Teodor12/ESP-32-SMART-LIGHTING/README.md

 An offline speech-recognition applicaton for the board ESP32-S3-DevKitC-1 and INMP441 I2S MEMS microphone.
