Teodor12/ESP-32-SMART-LIGHTING/szakdolgozat-obsolete.docx

Szegedi Tudományegyetem Informatikai Intézet

# Beltéri hangvezérelt világítás megvalósítása ESP32 mikrovezérlővel

# Indoor voice-controlled lighting

# using ESP32 microncontroller

Szakdolgozat

Készítette: | Témavezető:
Fodor Teodor | Dr. Mingesz Róbert
mérnökinformatikus szakos hallgató | egyetemi adjunktus

Szeged 2024

Feladatkiírás:

ESP32 mikrovezérlővel számos IOT-projektet elkészíthetünk. A mikrovezérlő sokoldalúságának és könnyen programozhatóságának köszönhetően a lehetőségek tárháza végtelen. Gyakori jelenség, hogy az épületek beltéri megvilágítását különböző elven működő érzékelővel vezérlik. A diplomamunkám célja, hogy a megszokott vezérléseket figyelmen kívül hagyva, egy sokkal kényelmesebb és képzeletet felülmúló, hangvezérelt megoldással álljak elő, amely lehetőleg gyors, könnyen felhasználható és alacsony hiba arányú. A dolgozat írása során természetesen törekszem megtalálni az arany középutat a felhasznált komponensek árában és minőségében, hiszen a legjobb ötlet sem valósítható meg a megfelelő céleszközök nélkül.

A feladat megvalósításának lépései:

1. Pontos specifikáció meghatározása
2. ESP32 fejlesztőkit és mikrofonok kiválasztása
3. Hardverek tesztelése (oszcilloszkóp, egyéb mérések)
4. Program implementálása
5. Program tesztelése
6. Áramkör elkészítése próbapanelen
7. Program javítása és bővítése

Tartalmi összefoglaló:

# A téma megnevezése:

# Beltéri hangvezérelt megvilágítás megvalósítása ESP32 mikrovezérlővel

# A megadott feladat megfogalmazása:

# A feladat követelménye, hogy egy két zónás (két különálló LED-szalagot) világítást tudjunk hanggal vezérelni.

# A megoldási mód:

# A kiválasztott ESP32 fejlesztőkit és mikrofonok közötti kommunikáció szoftveres megvalósítása, majd a az mesterséges intelligencia modellek beiktatása a hang felismeréséhez.

# Alkalmazott eszközök, módszerek:

# A programot a hivatalos, Espressif cég által biztosított ESP-IDF keretrendszert felhasználva készítem el, FreeRTOS-s környezetben. A kapcsolást először breadboard-on rakom össze, majd egy próbapanelen összeforrasztom (a két műveletet megelőzi egy áramkörtervezés).

# Elért eredmények:

# Mind a program, mind az áramkör is elkészült, így a szobámban már megtalálható a működő prototípus.

# Kulcsszavak:

# ESP-IDF, ESP32, I2S, INMP441, FreeRTOS

Tartalomjegyzék:

# 1. Bevezetés:

A hangvezérlés egy olyan technológia, amely lehetővé teszi a különböző eszközök és alkalmazások beszédhanggal való vezérlését. A hangvezérlést biztosító rendszerek használata egyre elterjedtebb a mindennapi életben, például okostelefonok, autók és egyéb elektronikus készülékek esetében. Napjainkban egy korszerű okosotthon szinte teljesen elképzelhetetlen hangvezérlés nélkül. A hangvezérlés egy olyan alternatíva, amely egy érintésmentes és kényelmes szolgáltatást biztosít a hagyományos vezérlési módszerekhez képest.

Felmérések alapján a felhasználók nagy része többnyire a következő 4 platform mellett teszi le a voksát: Apple Siri, Samsung Bixby, Amazon Alexa vagy Google asszisztens. A felsorolt szolgáltatások mindegyikére jellemző, hogy online, azaz felhő-alapú hangfelismerő algoritmusokat futtatnak nagy teljesítményű szervereken. A platformokat támogató termékek (Amazon Echo Dot, Amazon Echo Studio, Apple Homepod, Samsung televízió stb.) valójában egy mikrofonként szolgálnak, amelyek továbbítják a beszédhangot az előbb említett távoli számítógépeknek. Ezen rendszerek általában drágábbak, illetve a használatukhoz egyszerre több terméket is meg kell vásárolnunk. A diplomamunkámmal azt próbálom bemutatni, hogy van lehetőség jutányos áron beszerezni, kiépíteni egy olyan rendszert, amellyel egyszerű eszközök is hangvezéreltté tehetők. Például egy Amazon Alexát támogató villanykörte körülbelül 30 euróba, a hozzá tartozó legegyszerűbb Amazon Echo Dot 50 euróba kerül - az ellátott feladatot természetesen teljesítik az eszközok, azonban az ár egy kissé magas (az Alex-ás termékek árai messze elmaradnak az Apple termékeihez képest) egyetlen funkcionalitás megvalósításához. Az elkészített projekttel be szeretném mutatni, hogy sokkal kevesebb anyagi ráfordítással is megteremthető a fenti kényelmi funkció.

Fontos megjegyezni, hogy ha az ember ESP32 [1] mikrovezérlővel megvalósított hangfelismerés offline hangfelismerés [2], azaz az algoritmus magán az eszközön fut, ezért egy erősebb chip megvásárlása szükséges, amelyben több memória található, illetve az órajele is sokkal magasabb. Az ilyen chipek ára még mindig messzemenőleg elmarad egy felhő-alapú rendszerhez képest. A legegyszerűbb megoldás az, ha az ember vásárol egy olyan fejlesztőkitet, amiben már megtalálható a mikrofon is, így nem kell foglalkozni a hang eljuttatásával a mikrovezérlőbe. Találtam több kitet is, amelybe már integrálva voltak a mikrofonok, azonban a beszerzésük hosszadalmas és drágább folyamat lett volna. Ezért úgy döntöttem, hogy külön-külön beszerzem a fejlesztőkitet és a két mikrofont (lehetőleg olyan típusút, amelyek a hivatalos kitekbe is integrálva vannak) és elkészítem a közöttük lévő kommunikációhoz szükséges illesztőprogramot. A hangfelismerő algoritmust nem én készítettem, már része az ESP-IDF [3] keretrendszernek, és sajnos nem nyílt forráskódú a keretrendszer ezen könyvtára.

# Nem titkolt célja a projektnek, hogy egy pénztárcabarát és könnyen használható, illetve konfigurálható eszközt tervezzek, amely egyszerűbb vezérlési feladatok elvégzésére képes.

# 2. Hardverkörnyezet bemutatása:

# A felhasznált hardverek kiválasztásakor alábbi négy szempont szerint jártam el: legyen költséghatékony, könnyen elérhető, lehetőleg gyors legyen a kiszállítás és ne legyen gyárilag hibás.

## 2.1. A felhasznált mikrovezérlő és fejlesztőkit:


Az Espressif [4] cég ESP termékcsaládja eddig is népszerű volt a hobbi építők és az olcsó IoT eszköz gyártók körében, révén, hogy nagy tudása mellett, olcsó és könnyen programozható. Az elterjedt ESP8266 (illetve ESP8265 és változatai) leváltására érkezett az erősebb ESP32. Az ESP32 az elődjéhez képest sokkal több perifériával, nagyobb memóriával és magasabb órajellel rendelkezik. A programozható pinek száma megnőtt, illetve egyre több hálózati kommunikációs protokollt (Thread, Zigbee, Matter) is képesek támogatni a megszokott WiFi-n és Bluetooth-on kívül az újszériás ESP32 chipek. Az elmúlt évek során rengeteg változat jelent meg, mindegyik széria rendelkezik valamilyen specifikus képességgel, így az adott feladat követelményeinek megfelelően tudjuk kiválasztani a számunkra megfelelő chipet.

Ábra 1 – ESP32 csippel szerelt fejlesztőkit.
Forrás:[5]

Ábra 2 – ESP32-S3 csippel szerelt fejlesztőkit. Forrás:[6]


A diplomamunkámhoz az ESP32-S3 [6] AI SoC-t választottam, amely a már jól bevált két processzormagos, akár 240 MHz-es órajel elérésére is képes Xtensa LX7 vezérlőegységet tartalmazza. A mikrovezérlőt kifejezetten AIoT alkalmazásokhoz gyártotta az Espessif Systems cég 2020-ban. Az ilyen chipet tartalmazó modulok különlegessége, hogy tartalmaznak egy külső PSRAM (Pseudostatic RAM) memóriaegységet, 2,4,8 és 16 MB-os kapacitással, verziótól függően. A PSRAM [7] nagy méretének köszönhetően, lehetővé teszi a magas számításigényű mesterséges intelligencia algoritmusok (esetünkben hangfelismerő algoritmusok) futását, a nagy mennyiségű digitalizált hangadat pufferelését – kizárólag ezért használható csak az S3-as szériához a keretrendszer hangfelismerő könyvtára. A jelenlegi projekthez én ESP32-S3-DevKitC-1U-N8R8 chip-el ellátott ESP32-S3-DevKitC-1 v1.1 fejlesztőkitet választottam 8MB flash-memóriával és 8 MB PSRAM-mal. [6]


Ábra 3 – Espressif cég által gyártott PSRAM csip. Forrás: [7]

## 2.2. A felhasznált mikrofonok:

Annak érdekében, hogy a beszédhang digitalizálásával ne kelljen foglalkoznom, mindenképpen egy MEMS-technológiát használó mikrofont választottam, illetve egy olyan kommunikációs protokollt, amellyel könnyen le tudom implementálni a mikrofon és a fejlesztőkit közötti adatátvitelt. Ha körül nézünk a boltok polcain, akkor legtöbb ilyen típusú mikrofon az I²S kommunikációs szabványt támogatja. Az ESP-IDF pedig rendelkezik olyan könyvtárral, amely a fenti kommunikáció lebonyolításáért felelős.

### 2.2.1. A MEMS-technológia:

A MEMS mikrofonokat [8] vagy szilíciummikrofonokat már régóta előszeretettel használják okostelefonokban, okostévékben, távirányítókban. Ez nagy részben olyan hangvezérelt személyititkár-alkalmazásoknak köszönhető, amilyen a korábban is más sokszor emlegetett Amazon Alexa, a Google Assistant és az Apple termékek Siri-je. Ezek az alkalmazások olyan hangparancsokra várnak, amelyek ébresztik magát a rendszert, majd a parancs alapján hajtanak végre különböző utasításokat. A tervezők szűrőfunckiókat is integrálnak a mikrofonokba, hogy azok pontosan, jelentős környezeti zajban is messziről érzékeljék a beszédhangot.

A MEMS mikrofonok jellemzően két, egyazon tokban elhelyezett alkatrészből állnak: egy MEMS membránból, amely átalakítja a hanghullámokat elektromos jellé, valamint egy erősítőből, amely impedanciaátalakítóként működve használható analóg kimenő jelet ad a hangfrekvenciás jelfeldolgozó láncra. A harmadik alkotóelem – ha digitális kimenőjelre van szükség – egy analóg-digitális átalakító, amely szintén elhelyezhető ugyanabban a tokban, számunkra ez a fontos a projekt esetében. [8]

# A MEMS-mikrofonok fontosabb paraméterei a következők:

Jel-zaj viszony (signal-noise ratio, azaz SNR): a hasznos és a zavaró jel aránya dB-ben kifejezve. Minél alacsonyabb, annál több zaj jelenik meg a digitalizált adatokban. Törekedni kell a nagyobb jel-zaj viszonyú mikrofonok kiválasztására, így az eszköz kevésbé „zajosabb” és kevésbé érzékenyebb a zajra.

# Frekvenciaátvitel: megadja azt a hangfrekvencia tartományt, ahol a mikrofon képes érzékelni a beszédhangot.

# Dinamikatartomány: azon leghangosabb és leghalkabb hangnak megfelelő hangnyomásszint közti különbség, amelyek között a mikrofon jelleggörbéje lineáris.

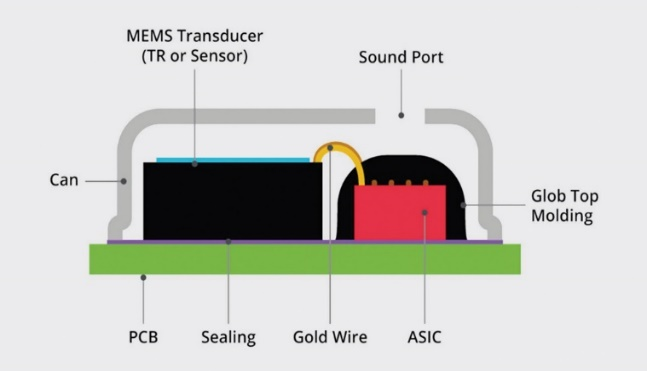
[picture p31: figure]

# Érzékenység: megadja, hogy a mikrofon egy 1 kHz-es 94 dB hangnyomású hanghullámra adott analóg/digitális kimeneti értékének nagyságát

Ábra 4 – MEMS mikrofon csip. Forrás: [9].

Ábra 5 – MEMS mikrofon belső felépítése. Forrás: [8].


Digitális MEMS mikrofon használata esetén a mikrofon kimenőjele közvetlenül rávezethető digitális áramkörökre, általában egy mikrovezérlőre. Az erősen zajos környezetekre tervezett hangvezérléses felhasználói felületek jellemzően inkább a digitális mikrofonokat részesítik előnyben, mert a digitális kimenő jeleknek nagyobb a zajtűrésük, illetve a kezelésük is könnyebb, mint az analóg társaiknak.

### 2.2.2. INMP441:


Az INMP441 [10] egy olcsó és könnyen beszerezhető, alacsony fogyasztású MEMS mikrofon modul. Fontos tulajdonsága, hogy I²S kimeneti interfésszel rendelkezik és omnidirekcionális, ami azt jelenti, hogy minden irányból egyformán érzékeli a hangot. A kimenete 24-bites és könnyen alkalmazható sztereó módban, azaz egyszerre 2 azonos típusú mikrofont is könnyen használhatunk - az architektúrájából kifolyólag szinkronizálva van a mikrofonok közötti adatátvitel.

Ábra 8 – INMP441 mikrofonnal szerelt mikrofon. Forrás: [11].

Ábra 7 – 2 INMP411 mikrofon sztereó módban használva.
Forrás: [10].

Ábra 6 – az INMP441 mikrofoncsip belső felépítése. Forrás: [10].

# A fenti ábrán jól látható a „L/R” pin a mikrofon blokkdiagramján – ennek segítségével konfigurálható, hogy az eszköz a „jobb” vagy a „bal” oldali csatornán küldje a

# kimeneti adatot. Az 7-es ábra szemlélteti a sztereó-kimenet kapcsolását.

Jól látható, hogy az egyik mikrofon csip L/R pinjét tápfeszültségre, míg a másik eszköz L/R pinje GND-re van csatlakoztatva. Az ábrán feltüntetett szűrőkondenzátorok és ellenállások már alapból megtalálhatóak a mikrofonos lapocskán, ezért használatuk elhanyagolható. Az ábra utolsó fontos eleme, a „SYSTEM MASTER” blokk esetünkben nem más, mint maga az ESP32 S3-as fejlesztőkit.

### 2.2.3. I²S szabvány:

Az I²S [12] (Inter-IC Sound) egy elektronikus soros busz interfész szabvány, amelyet digitális audióeszközök összekapcsolására használnak. Ezt a szabványt először a Philips Semiconductor vezette be 1986-ban. Digitális audió adatok átvitelére használják az elektronikus eszközök integrált áramkörei között. A kimenet PCM-formátumú.

# Összesen 3 jelalak jellemzi:

# Bit órajel – az általunk használt mikrofon esetében ez az SCK-pinen (serial clock) jelenik meg. Feladata a bitek átvitelének az ütemezése

Szó óravonal – formálisan ez a mikrofon WS-pinjének (word select) a jele. Feladata, hogy sztereó kimenet esetén kiválasztja, hogy a jobb vagy bal oldali csatornáról szeretnénk fogadni az adatot. Logikai alacsony szint esetén a bal-, míg logikai magas jelszint esetén a jobb csatornáról történik az adat olvasása. Leegyszerűsítve ez a mintavételi frekvencia egy szóra vonatkozóan, ami esetünkben 24-bit (32 bit).

# Soros adatvonal – ezen az adatvonalon jelennek meg a mikrofon által digitalizált adatok bájtjai. Az INMP441 mikrofon esetén ez az SD-pin (serial data).


Ábra 7 – Az I2S idődiagramja. Forrás: [12].


Ábra 8 – Az INMP441 mikrofon I2S idődiagramja sztereó-kimenet esetén.
Forrás: [10].

Adatlap alapján a mikrofon kimenetén 24-bites adatok jelennek meg, amelyek a legnagyobb helyiértékű bittel kezdődnek. A dolog érdekessége, hogy mégis 32 jelenik meg egy fél-WS-ciklus (1 darab csatorna olvasása) alatt. Ez azzal magyarázható, hogy a mikrofon ilyenkor egy magas impedanciás állapotba kerül – ezek a bitek számunkra közömbösek és a szoftveres lekezelésénél is figyelmen kívül hagyjuk őket. Kicsit nehezebben észrevehető, de még mielőtt kiolvasnánk a digitalizált adat legnagyobb helyiértékű bitjét a WS-ciklus elején, szükségünk van egy bit-órajel impulzusra (eltolás), ez a formátum a „Philips formátum”. Az ESP-IDF I²S könyvtárában [13] ez szerencsére gond nélkül konfigurálható. Fontos még kiemelni, hogy egy teljes WS-ciklus alatt 64 SCK impulzusnak kell megjelennie annak ellenére, hogy csak 24 bit a számunkra értékes információ. [8]


Ábra 9 – az INMP441 vizsgálata oszcilloszkóppal. Kékkel a WS-, pirossal az SCK- és zölddel az SD- jel látható.

## 2.3. A felhasznált LED szalag:

Végül, de nem utolsó sorban a megvilágításért felelős LED-szalagról teszek említést. A két szalagot a szobámban található két szekrény hátoldalán helyeztem. Miután lemértem a szekrények hosszait, méretre vágtam a szalagokat, végül felragasztottam őket. Ehhez a szalagon található ragasztón kívül még univerzális ragasztót is felhasználtam a biztos tapadás érdekében. Összesen 3 méter szalagra volt szükségem, amelyekről a gyári csatlakozót le kellett cserélnem csupasz vezetékekre.

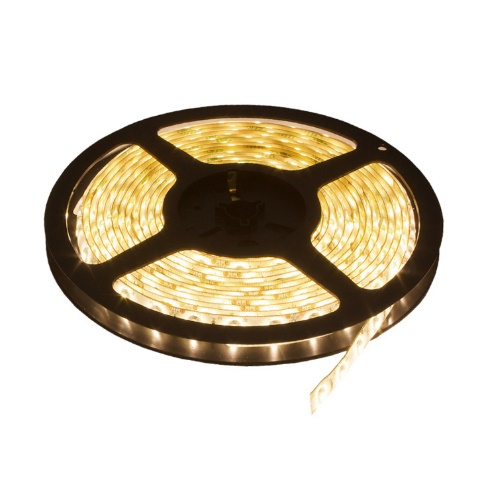
[picture p32: figure]

A műszaki paramétereket áttekintve egy 12 V-on működő, méterenként 120 LED diódával szerelt szalagról van szó, 3000K színmélységgel (ún. “meleg fehér” a szalag által emittált fénysugár). Számomra fontos paraméter volt a dimmelhetőség, mivel egyszere 5-6 különböző fényerősséget szerettem volna felkínálni, amelyeket a hangparancsokkal lehet változtatni. A különböző fényerősségek eléréséhez természetesen PWM-jelet alkalmaztam.

Ábra 10 – COB LED-szalag. Forrás: [14]


Kihagyhatatlan volt a felhasznált teljesítmény és áramerősség meghatározása is, hiszen a rendszerhez egy megfelelő méretű tápegységet is be kellett szereznem. Mérések és kísérletezés alapján a két LED szalag egyenként 750 mA-t fogyasztott (maximális fényerősség esetén), illetve a mikrovezérlő elenyésző fogyasztását is beleszámoltam, aminek eredménye egy 3A áramerősségű 12 voltos tápegység [15] lett. (230V hálózati feszültségről alakít). A fejlesztőkit tápfeszültséggel való ellátásáért egy LM2596 [16] DC-DC kapcsolóüzemű konvertert használtam, melynek kimeneti feszültségét 3.3V-ra állítottam.

Ábra 11 – a projekt megvalósításához felhasznált tápegységek. Bal oldalon a 12V-os AC/DC átalakító, jobb oldalon pedig az LM2595-os DC/DC átalakító. Forrás: [15, 16].

## 2.4. Egyéb felhasznált eszközök:

# Műanyag doboz – 95 x 60 mm méretű, az áramkör tárolására

# Próbapanel – a dobozhoz mérten méretre vágtam, erre forrasztottam az áramkört

# IRL540N [17] logikai MOSFET – a két LED szalag meghajtására használtam. Önmagában az ESP32 fejlesztőkit GPIO lábai nem képesek 12 voltos eszközöket meghajtani. A tranzisztor threshold feszültsége 1.8-1.9 V, ami könnyen kapcsolható a kit 3.3 V-os pinjeivel. [14]

# Ellenállások – 100 Ω és 10 kΩ értékkel

# 2.54mm lábtávolságú aljzat: a fejlesztőkit és a mikrofonok könnyebb rögzítéséhez és esetleges cseréjéhez

# DC-csatlakozó – egy tápegység, egy csatlakozó. Az egyszerűség kedvéért barrel-jack-t használtam

# Kétutas csavaros sorkapocs – ezzel kötöttem a LED szalagokat az áramkör kimeneteire

## 2.5. A felépített áramkör:

Ábra 12 – a projekthez használt áramkör kapcsolási rajza


A fenti ábra alaposan bemutatja az általam tervezett áramkört. A program, amelyet használtam a kapcsolási rajz elkészítéséhez a nyílt-forráskódú és ingyenesen letölthető KiCad. A könnyebb átláthatóság érdekében a vezetékek helyett címkéket használtam (pl. OUTPUT1, I2S_SDIN stb.). Szeretném kiemelni, hogy az áramkör 3 dimenziós modelljét, amely a nyomtatott áramköri lapot tartalmazza, nem készítettem el, ezért is érdemesebb a rajzra egy funkcionális diagramként tekinteni, amely a forrasztás során segített létrehozni a megfelelő kapcsolásokat (erre jó példa a LM2596 DC-DC átalakítónak csak a integrált áramköri komponense van feltüntetve az ábrán). A sokszor felhasznált részeket (+12v, GND) egységesítettem.

Jobb felső sarokban található az áramkör tápellátásért felelős részegység. A J1-es jelzésű BarrelJack-en keresztül tápláljuk meg 12 volttal a rendszert a 13-as ábrán található AC-DC tápegységgel. Ezt a 12 volt feszültséget használjuk fel a LED szalagok meghajtására illetve közvetett módon a fejlesztőkit áramellátására is: az LM2596 DC-DC átalakító a 12 voltot 3.3 voltra alakítja át, amely a fejlesztőkit 3V3 kivezetésére csatlakozik.

Az ábra bal alsó sarkában látható a ESP32 S3 fejlesztőkit. Az „I²S” előtaggal rendelkező kivezetéseket szabadon választottam, ügyelve arra, hogy az eszköz működéséhez szükséges pineket (BOOT, GND, RST stb.) ne használjam. Hasonló módon jártam el az OUTPUT1 és OUTPUT2 pinek esetén is, általános célú lábakat választottam, amelyek a későbbiekben a váltakozó kitöltési tényezőjű PWM-jeleket juttatják el a logikai MOSFET tranzisztorokra.

Az ábra bal felső sarkában található a két darab INMP441-es omnidirekcionális mikrofonmodul. Ezeket is LM2596-os feszültségkonverter látja el tápfeszültséggel, adatlapi értékek alapján maximálisan 3.6V-al táplálhatóak. A korábban említett sztereó konfiguráció érdekében az egyik L/R kivezetését a rendszer földpontjára, míg a másikat 3.3 V feszültségre kötöttem. A további három vezeték az I²S által szükséges jelek továbbítására szolgál, amelyek az I2S_WS (word select), I2S_SD (serial data) és I2S_SCK (serial clock).

Az áramkör utolsó részegysége a LED szalagok meghajtásáért felelős aláramkör a kapcsolási rajz jobb alsó sarkában. Az RG1 és RG2 ellenállások 100 Ω-sak, míg az RGND1 és RGND2 10kΩ-sak. Az RGND1 és RGND2 ellenállások lehúzó ellenállásként funkcionálnak, így biztosítva azt, hogy a mikrovezérlő bootolásakor a tranzisztorok kimenetei nem magas impedanciás-, hanem biztosan kikapcsolt állapotban vannak. Az RG1 és RG2 ellenállás megléte nem kötelező, hiszen a logikai térvezérlésű tranzisztorokat elméleti szinten kizárólag feszültséggel vezéreljük, azonban tudjuk, hogy a gyakorlatban némi áram is megjelenik a mosfet gate-jén – a két ellenállás a túláramok ellen biztosít védelmet. [18] Noha a egy feszültségosztó áramkört kapunk, az RG1 és RG2 ellenállásértékei elenyészőek a 10kΩ-hoz képest, ezért a jelenlétük nem fogja zavarni a működést:

# R1 = 100 Ω

# R2 = 10000 Ω

# V = V_(out) * ((R2)/((R1 + R2)))= 3.3V*( (10000Ω)/(10100 Ω))=3.267 V

A kapott „V” feszültség érték messze meghaladja az IRL540 fet threshold feszültéségét (kb. 1.8-1.9 V). A tranzisztor drain kivezetése a csavaros sorkapocs egyik lábára csatlakozik, természetesen arra, amelyre a LED szalag negatív polaritású vezetékét kötöttem, míg másikra, amelyen a 12V-os tápfeszültség van, a szalag pozitív vezetéke került bekötésre. A tranzisztorokat meghajtó pwm-jel biztosítja azt, hogy azokat kapcsolóüzemben használjuk így további munkapont beállításra nincs szükség. A tranzisztor N-csatornás, így a bemeneten megjelenő négyszögjel a szalag földpontját nagyfrekvencián szaggatja” (dimmeli), a váltakozó kitöltési tényező pedig a jel effektív értékét, azaz a fényerőt szabályozza.

# 3. Szoftverkörnyezet bemutatása:

## 3.1. Espressif IoT Development Framework:

Az ESP-IDF a kínai Espressif cég által fejlesztett keretrendszer, amelyet az ESP8266- és ESP32 sorozatú mikrovezérlők programozására használunk. Az szoftvercsomag rengeteg API-t kínál, amellyel kényelmesen programozható a mikrovezérlő minden egyes perifériája és felkínált szolgáltatása, C és C++ programozási nyelveken egyaránt. Fontos kiemelni, hogy maga a keretrendszer és annak szoftverkomponensei a FreeRTOS [19] valós-idejű operációs rendszer alapjaira vannak lefektetve, amely kivétel nélkül mindegy egyes Espressif-es csipet támogat-

A keretrendszer nagy előnye, hogy teljesen nyílt-forráskodú, szabadon megtekinthetőek a forrásfájlok a hivatalos GitHub repository-ban, emellett jól dokumentált, minden apró részletre kitér és, ami a legfontosabb, hogy az egyes könyvtárakhoz példaprogramokat is bemutat, amelyek a dokumentáció olvasásával kombinálva megkönnyítik és felgyorsítják a fejlesztést. [3]


## 3.2. FreeRTOS:

Ábra 13 – az idf.py menuconfig parancs futtatása után megjelenik a konfigurátor interfész, jelen esetben a FreeRTOS-ra vonatkozó opciókat láthatjuk


A valós idejű operációs rendszer, mint olyan, egy erőforráskímélő operációs rendszer, amely lehetővé teszi a többfeladatos programvégrehajtást. Maga a „valós idő” az adott folyamat elvégzéséhez szükséges idő determinisztikusságára és (vagy) mennyiségének megjósolhatóságára utal. A beágyazott rendszerek többnyire valós idejű (Real-Time) követelményeket támasztanak, ami azt jelenti, hogy egy-egy esemény bekövetkezésére adott időkorláton belül reagálni kell. [19]

Ábra 14 – FreeRTOS logó. Forrás: [19].

### 3.2.1. Feladatok:

A FreeRTOS az adott feladatok (taszk) között osztja meg az hardver erőforrásait. A taszkok egymástól független végtelen ciklusban futó függvények, amelyek az adott mikrovezérlő heap-memóriájából foglalnak le a stack-ük nagyságával megegyező memóriát. Bár a taszkok logikailag el vannak szigetelve egymástól, az MPU (memória védelmi egység) a különböző memóriaterületek védelmét szolgálja, megakadályozva, hogy egy taszk egy másik taszk memóriaterületére írjon vagy olvasson. [19]

# A feladatok különböző állapotúak lehetnek:

# Blokkolt (blocked/suspended) – a feladat eseményre vár (pl. késleltetés leteltére, adatok/erőforrások elérhetővé válására)

# Felfüggesztett (suspended) – a feladat nem kap erőforrást és nem kerül ütemezésre

# Készenléti (ready) – a feladat a CPU-n történő futásra kész, de nem fut, mert a CPU erőforrásait egy másik feladat használja

# Futó (running) – a CPU erőforrást biztosít a feladat futásához

### 3.2.2. Rendszerórajel:

A FreeRTOS-nak szüksége van egy időalapra az idő méréséhez, illetve az ütemező működéséhez. Ez általában egy számláló változó segítségével valósul meg, amelyet a hardver egy periodikusan generált megszakításkezelő függvényben növel. A rendszerórajelnek köszönhetően egy alkalmazás több időalapú szolgáltatást (feladat-végrehajtási intervallumot, várakozási időtúllépést, időszeletelést) képes fenntartani egyetlen hardveres időzítő használatával. A gyorsabb rendszerórajel azonban csak az RTOS időalap felbontását növeli, a szoftver futási ideje nem javul tőle. [19]

### 3.2.3. Ütemező:

A FreeRTOS-ban futó feladatok ütemezését az ütemező végzi. Típusa szerint ez egy preemptív ütemező, ami azt jelenti, hogy a taszkokhoz a létrehozásukkor egy prioritás értéket rendelünk, így az ütemező ezen érték alapján osztja meg az erőforrásokat és a processzoridő a taszkok között. A különböző értékek megléte miatt a magasabb prioritással rendelkező feladatok megszakíthatják az alacsonyabb prioritással rendelkező társaikat. [19]

### 3.2.4. Feladatok közötti kommunikáció (ITC):

Ha több feladatot futtatunk párhuzamosan, gyakori jelenség a köztük lévő információcsere, illetve egy globális változó írása/olvasása. Az ilyen „közös” entitások megléte gyakran idézhet elő versenyhelyzetet. Ekkor kettő (vagy több task) egyszerre próbálja meg elérni a globálist változót, ami a benne lévő adat sérülését okozhatja. Az információk megosztása mellett a FreeRTOS-objektumok képesek szinkronizálni a feladatok végrehajtását is. A feladatok blokkolhatóak, várhatnak egymásra – ez esetben a jelenhet a meg holtpont (dead-lock), amikor két vagy több taszk egymást blokkolja, mivel mindegyik vár valamilyen erőforrásra, amit egy másik birtokol. Ennek eredményeként egyik folyamat sem tud előre haladni, és a rendszer megreked. [19]

# A FreeRTOS a következő objektumokkal rendelkezik:

# Üzenetsor (queue vagy message queue) - Adatok küldésére szolgál a feladatok vagy a megszakítás és a feladat között, FIFO technikát alkalmaz

# Mutex –egyetlen erőforrás használatának védelmére használatos

# Szemafor - Az erőforrások használatának védelmére vagy a feladat-végrehajtás szinkronizálására szolgál. Lehet bináris- és számláló szemafor.

# Eseménycsoport (Event group): valójában egy 8- vagy 16 bites változó, melynek a meghatározott bit-kombinációi egy adott állapotot vagy esemény bekövetkezését jelzik.

# 4. A program bemutatása:

A projekt megvalósításához összesen 4 komponenst készítettem el. Ezek a hardware_driver, led_indicator, pwm_output és voice_assistant. A projekt architektúráját tekintve a voice_assistant a program fő része, hiszen megteremti a kapcsolatot a fennmaradó 3 komponens között, amelyek egymástól teljesen függetlenül is működőképesek, azonban az elvárt követelmény a képességeik kombinálásával teljesíthető. A program belépési pontja a szokásos „app_main” függvényben található, amely elindítja a voice_assistant komponensben található taszkokat. Minden inicializációs- és konfigurációs lépés a taszkok indulása előtt fut le, hiba esetén jelez a program. A következő fejezetben az elkészített komponenseket mutatom be lépésről-lépésre haladva – minden egyes részegységnél ügyeltem arra, hogy a „publikus header” fájlokban csak az olyan függvényeket helyezzem el, amelyeket később a főprogramban hívok meg és próbáltam a lehető legjobban elrejteni a valós implementációt (fekete doboz). Az alábbi ábrával szemléltetem a teljes projekt logika felépítését, amely útmutatóként szolgál.


Ábra 15 – az idf-projekt strultúrája

## 4.1. A hardware_driver komponens:

A hardware_driver komponens felelős a fejlesztőkit és a két INMP441 típusú mikrofon közötti I²S kommunikáció megvalósításáért. A program talán második legfontosabb része, hiszen egy alapból nem beépített funkcionalitással/képességgel látja el a fejlesztőkitet – jelen esetben a beszédhang digitalizálását, majd a digitalizált értékek mikrovezérlőbe való továbbításáról beszélünk.

# Header fájl(ok):

esp_err_t bsp_board_init(uint32_t sample_rate, int

channel_format, int bits_per_chan);

esp_err_t bsp_read_i2s_data(int16_t *buffer, int buffer_size);

esp_err_t bsp_board_deinit(void);

int bsp_board_channel_fmt(void);

#define GPIO_I2S_WS (GPIO_NUM_11)

#define GPIO_I2S_MCLK (GPIO_NUM_NC)

#define GPIO_I2S_SCLK (GPIO_NUM_12)

#define GPIO_I2S_DIN (GPIO_NUM_10)

#define GPIO_I2S_DOUT (GPIO_NUM_NC)

#define I2S_CONFIG_DEFAULT(sample_rate, channel_fmt, bits_per_chan)

{

.clk_cfg = I2S_STD_CLK_DEFAULT_CONFIG(sample_rate),

.slot_cfg = I2S_STD_PHILIPS_SLOT_DEFAULT_CONFIG(bits_per_chan, channel_fmt),

.gpio_cfg = {

.mclk = GPIO_I2S_MCLK,

.bclk = GPIO_I2S_SCLK,

.ws = GPIO_I2S_WS,

.dout = GPIO_I2S_DOUT,

.din = GPIO_I2S_DIN,

.invert_flags = {

.mclk_inv = false,

.bclk_inv = false }}

};

A bsp.h (felül) tartalmazza a komponens által publikusan felkínált függvények deklarációját, míg az esp32_s3_devkitc_config.h (alul) a közvetlen módon definiált pineket, amelyeket később az I²S a komponens implementációjánál használtam fel. A “GPIO_NUM_NC” jelzi, hogy az adott pineket nem használjuk majd – az DOUT pinre azért nincs szükségünk, mert nem küldünk adatot a fejlesztőkitből, illetve felesleges az MCLK is, mivel nem biztosítok referencia órajelet a mikrofonoknak.

# Source fájl(ok):

#include "freertos/FreeRTOS.h"

#include "freertos/semphr.h"

#include "esp_log.h"

#include "esp32_s3_devkitc_config.h"

#include "driver/i2s_std.h"

#include "driver/i2s_common.h"

#include "bsp.h"

#define TAG "bsp"

static SemaphoreHandle_t i2s_mutex = NULL;

static i2s_chan_handle_t rx_handle = NULL;

static esp_err_t init_i2s_mutex(void)

{

i2s_mutex = xSemaphoreCreateMutex();

return (i2s_mutex != NULL) ? ESP_OK : ESP_FAIL;

}

A mutex-k használatára azért volt szükség, mert a program egyszerre több taszkot fog párhuzamosan futtatni: könnyen kialakulhatnak olyan helyzetek, amikor egy adott entitást már az előtt szeretnénk használni, hogy befejeződött volna az alap állapotba való helyezése. Mutex használatával könnyen és elegánsan tudjuk elérni, hogy egyszerre több folyamat ne tudja elérni az adott memóriaterületet, így elkerülve az esetleges felülírásokat és befejezetlen inicializációs lépéseket.

static esp_err_t i2s_init(i2s_port_t i2s_port_num, uint32_t sample_rate, int channel_format, int bits_per_chan)

{

esp_err_t ret = ESP_OK;

ESP_ERROR_CHECK(init_i2s_mutex());

xSemaphoreTake(i2s_mutex, pdMS_TO_TICKS(0));

i2s_chan_config_t channel_cfg = I2S_CHANNEL_DEFAULT_CONFIG(i2s_port_num,

I2S_ROLE_MASTER);

ret |= i2s_new_channel(&channel_cfg, NULL, &rx_handle);

i2s_std_config_t std_cfg = I2S_CONFIG_DEFAULT(sample_rate, channel_format,

bits_per_chan);

ret |= i2s_channel_init_std_mode(rx_handle, &std_cfg);

ret |= i2s_channel_enable(rx_handle);

xSemaphoreGive(i2s_mutex);

return ret;

}

Az implementáció elrejtéséhez a C-programozási nyelven static függvényeket használunk, ez a kulcsszó jelzi a fordítóprogramnak, hogy az adott függvényt csak az őt tartalmazó fordítási egységből tudjuk elérni és hívni (ebben az esetben az őt tartalmazó fájlból). A szálbiztos inicializáció abban merül ki, hogy a mutex-t zároljuk, majd az inicializációt követően. „visszaadjuk”.

esp_err_t bsp_board_init(uint32_t sample_rate, int channel_format, int bits_per_chan)

{

esp_err_t ret = ESP_OK;

ret |= i2s_init(I2S_NUM_1, sample_rate, channel_format, bits_per_chan);

if(ret == ESP_OK){

ESP_LOGI(TAG, "I2S peripherial intialized successfully.");

}

else {

ESP_LOGI(TAG, "Error while initializing I2S peripherial.);

}

return ret;

}

# A bsp_board_init publikus függvény valójában csak meghívja a felhasználó elől elrejtett, statikus i2s_init függvényt – callback pattern. Amennyiben i2s periféria inicializálása sikertelen, hibaüzenetet ír ki és visszatér valamelyik esp-idf hibát jelző értékkel, például ESP_FAIL.

static esp_err_t i2s_read_data(int16_t *buffer, int buffer_size)

{

esp_err_t ret = ESP_OK;

size_t bytes_read;

int sample_num = (buffer_size / sizeof(int16_t));

int32_t *temp_buffer = (int32_t *)calloc(sample_num, sizeof(int32_t));

if (temp_buffer == NULL) {

ret = ESP_ERR_NO_MEM;

return ret;

}

i2s_channel_read(rx_handle, temp_buffer, sample_num * sizeof(int32_t), &bytes_read, portMAX_DELAY);

for (int i = 0; i < sample_num; i++) {

buffer[i] = (temp_buffer[i] >> 14);

}

free(temp_buffer);

return ret;

}

esp_err_t bsp_read_i2s_data(int16_t *buffer, int buffer_size)

{

esp_err_t ret = ESP_OK;

ret |= i2s_read_data(buffer, buffer_size);

return ret;

}

Az i2s_read_data függvény under-the-hood módon végzi el a konfigurált I²S-csatornán az adatok beolvasását a paraméterként kapott buffer-be, melynek a mérete buffer_size (bájtokban mérve). A függvény törzsében dinamikusan allokáltam egy 32-bites egészeket (tudjuk, hogy a mikrofonok kimenete 24-bites) tároló tömböt sample_num méretben. A sample_num valójában a később bemutatott hangfelismerő algoritmus által meghatározott hangminta (16-bites érték) mennyisége. Ahhoz, hogy a 32-biten tárolt 24-bites értékek a megfelelő módon kerüljenek a paraméterként megadott pufferbe, el kell shiftelnünk őket a megfelelő mértékben – ügyelve arra is, hogy a felső 8-bit a 32-ből magas impedanciás (jelen esetben határozatlan vagy nulla). Utolsó lépésként szigorúan felszabadítjuk a lefoglalt memóriát.

## 4.2. A led_indicator komponens:

# Az alábbi részegység a felhasználóval való interakciót valósítja meg: lényege, hogy a konfigurált ébresztő hangparancsokra (wakeword) bekapcsolja a fejlesztőkiten található

# RGB-LED izzót. A fehér fényű dióda mindaddig világít, amíg a hangfelismerő algoritmus aktív, ez konfigurációtól függően 5-7 másodperc.


A beépített RGB LED-dióda egy WS2812 [20] modellszámú intelligens, és címezhető dióda. Gyakran alkalmazzák különböző fényeffektusok és egyedi világítást megvalósító projektekhez. Ezekben a LEDek-ben egyetlen integrált áramkör található, amely tartalmazza a piros, zöld és kék diódákat, valamint egy csipet, amely az általuk kibocsátott fény erősségéért, színéért és vezérléséért felelős.

Ábra 16 – az ESP32-S3 fejlesztőkit blokkdiagrammja, pirossal megjelölve a beépített RGB LED-dióda. Forrás: [6].

A diódát még az teszi vonzóvá, hogy egyetlen vezeték elegendő a kommunikáció lebonyolításához: szinte bármilyen mikrovezérlő GPIO-pinjét használva megvalósítható a kommunikáció. A kommunikáció lényege, hogy a mikrovezérlő 24 bites adatcsomagokat küld: az adatcsomagban három 3 8-bites (0-255 skálán terjedő) érték található, amelyek rendre a piros, zöld és kék „fénykomponens” intenzitását reprezentálják. Fontos megjegyezni, hogy a logikai 0 és 1-es érték is kódolva van az ábrán látható módon:


Ábra 17 – a WS2812-es típusú LED-dióda kommunikációs protokolljában felhasznált kódolás. Forrás: [20].

Ahhoz, hogy a diódában levő vezérlő csip a kívánt színkombinációkat tudja előállítani, a logikai nullák és egyesek kódolásnál szigorúan be kell tartani az időzítéseket: a protokoll esetében mind a 4 időtartam (T0H, T0L, T1H és T1l) mikroszekundumos skálán mozog. Külön-külön meghatározott ideig kell, hogy tartson – egy illesztőprogram megírásánál ez nehézkes és meglehetősen időigényes lehet.

# Szerencsére az ESP-IDF nem hivatalos komponensei (ESP Component Registry weboldal [21]) között található a WS2812 (és a hozzá hasonló) diódatípus programozásához szükséges könyvtár – az espressif_ledstrip. Az ilyen és ehhez hasonló könyvtárak az alábbi paranccsal adhatók hozzá a projekthez:

idf.py add-dependency "espressif/led_strip^2.5.4"

# A parancs lényege, hogy létrehozza a projekt main mappájában az idf_component.yaml fájlt az alábbi módon:

dependencies:

espressif/led_strip: "^2.5.3"

idf:

version: ">=4.1.0"

# A fájl tartalmának köszönhetően most már komponensként hozzáadhatjuk az általunk definiálthoz (jelen esetben led_strip) és az #include paranccsal tudjuk beilleszteni az adott forrásfájlba.

# Header fájl:

typedef struct led_indicator *led_indicator_t;

led_indicator_t led_indicator_init();

esp_err_t led_indicator_start(led_indicator_t led_indicator);

esp_err_t led_indicator_turn_on(led_indicator_t led_indicator);

esp_err_t led_indicator_turn_off(led_indicator_t led_indicator);

# A header fájlban definiáltam egy pointert a kód írásának megkönnyítéséhez, amely az általam létrehozott struktúrára mutat (led_indicator_t) – ez a struktúra szintén el van rejtve a header fájlt használó komponensek elől, csak a forrásfájlban található meg.

# Forrásfájl

#include "freertos/FreeRTOS.h"

#include "freertos/semphr.h"

#include "led_indicator.h"

#include "led_strip.h"

#define LED_INDICATOR_PIN 38

static SemaphoreHandle_t led_indicator_mutex = NULL;

struct led_indicator {

led_strip_handle_t led_strip;

bool run;

bool led_state;

};

static led_strip_handle_t configure_led(void)

{

led_strip_config_t strip_config = {

.strip_gpio_num = LED_INDICATOR_PIN,

.max_leds = NUM_OF_LEDS,

.led_pixel_format = LED_PIXEL_FORMAT_GRB,

.led_model = LED_MODEL_WS2812,

.flags.invert_out = false,

};

led_strip_spi_config_t spi_config = {

.clk_src = SPI_CLK_SRC_DEFAULT,

.flags.with_dma = true,

.spi_bus = SPI2_HOST,

};

led_strip_handle_t led_strip;

ESP_ERROR_CHECK(led_strip_new_spi_device(&strip_config, &spi_config, &led_strip));

ESP_LOGI(TAG, "Created LED strip object with SPI backend");

return led_strip;

}

led_indicator_t led_indicator_init()

{

led_indicator_t led_indicator = (led_indicator_t)calloc(1, sizeof(struct led_indicator));

if(led_indicator == NULL){

ESP_LOGE(TAG, "memory exhausted");

return NULL;

}

led_indicator->led_strip = configure_led();

ESP_ERROR_CHECK(init_led_indicator_mutex());

ESP_ERROR_CHECK(turn_off(led_indicator));

led_indicator->run = false;

return led_indicator;

}

A LED_INDICATOR_PIN konstans a fejlesztőkit 38-as GPIO pinjét jelzi, amely össze van kötve a beépített LED diódával. A led_strip_handle_t, led_strip_config_t és a led_strip_spi_config_t a led_stip.h header-ben definiált struktúrák, amelyet a konfiguráláshoz használunk. A led_indicator_init függvényben előszőr létrehozok egy led_indicator entitást, melynek ezután az adattagjait is inicializálom a statikus configure_led függvény visszatérési értékével. A configure_led függvény egyik érdekessége még, hogy a könyvtár lehetőséget ad arra, hogy a mikrovezérlőbe épített SPI periféria segítségével végezzük el a korábban említett időzítéseket a logikai nullák és egyesek kódolásához.

static void led_indicator_task(void *arg)

{

led_indicator_t led_indicator = (led_indicator_t) arg;

led_strip_handle_t led_strip = led_indicator->led_strip;

led_indicator->run = true;

while (led_indicator->run) {

if(led_indicator->led_state){

/*Setting the LED's color to white*/

ESP_ERROR_CHECK(led_strip_set_pixel(led_strip, 0, 32, 32, 32));

ESP_ERROR_CHECK(led_strip_refresh(led_strip));

}

else{

ESP_ERROR_CHECK(led_strip_clear(led_strip));

}

vTaskDelay(pdMS_TO_TICKS(100));

}

vTaskDelete(NULL);

}

esp_err_t led_indicator_start(led_indicator_t led_indicator)

{

if(led_indicator == NULL) {

ESP_LOGE(TAG, "led_indicator instance is NULL");

return ESP_FAIL;

}

if(xTaskCreate(&led_indicator_task, "led_indicator_task", 2*1024, led_indicator,5,NULL) != pdTRUE) {

ESP_LOGE(TAG, "error starting led_indicator task");

return ESP_FAIL;

}

return ESP_OK;

}

A statikus led_indicator_task egy FreeRTOS feladatot valósít meg, amely a paraméterként átadott led_indicator_t típusú entitás adattagjainak állapotával fogja elvégezni a LED dióda ki- és bekapcsolását. A taszk egy végtelen ciklusban fut, amely ellenőrzi, hogy az indicator objektum logikai típusú led_state adattagjának értéke igaz vagy hamis. Ezen logikai érték alapján fogja fehér színűre kapcsolni a diódát. A led_indicator_start függvény pedig a taszk létrehozásáért felelős, amely még azt is ellenőrzi, hogy megtörtént-e minden szükséges beállítás.

esp_err_t led_indicator_turn_on(led_indicator_t led_indicator){

return turn_on(led_indicator);}

esp_err_t led_indicator_turn_off(led_indicator_t led_indicator){

return turn_off(led_indicator);}

# Az alábbi két függvényt pedig az indicator objektum led_state változójának billentésére használom, amely szálbiztos módon történik a turn_on és turn_off függvények segítségével:

static esp_err_t turn_on(struct led_indicator *led_indicator)

{

if(xSemaphoreTake(led_indicator_mutex, pdMS_TO_TICKS(5)) != pdTRUE) {

return ESP_FAIL;

};

led_indicator->led_state = true;

xSemaphoreGive(led_indicator_mutex);

return ESP_OK;

}

static esp_err_t turn_off(struct led_indicator *led_indicator)

{

if (xSemaphoreTake(led_indicator_mutex, pdMS_TO_TICKS(5)) != pdTRUE) {

return ESP_FAIL;

};

led_indicator->led_state = false;

xSemaphoreGive(led_indicator_mutex);

return ESP_OK;

}

## 4.3. A pwm_output komponens:


A pwm_output komponens a különböző fényintenzitások előállításáért felelős: a működéséhez felhasznált periféria és az ehhez készített könyvtár a LEDC [22], azaz LED Controller. A periféria összesen 8 csatornán képes különböző frekvenciájú és változtatható kitöltési tényezőjű PWM-jelet generálni, amellyel a projekthez megépített kimeneti áramkörben található logikai tranzisztorokat vezérlem.

Ábra 18 – a LEDC periféria belső felépítésének blokkdiagramja, egy csatornára vonatkozóan. Esetünkben a LED blokk helyett egy IRL540N tranzisztorra van kapcsolva a kimenete. Forrás: [22].

# Header fájl:

esp_err_t init_pwm_outputs(void);

esp_err_t update_pwm_outputs(int command_id);

esp_err_t stop_pwm_outputs(void);

A header fájl összesen 3 függvényt tartalmaz, amelyek közül az első kettő a számunkra igazán fontos. Az init_pwm_outputs csak egy wrapper-függvény a belső inicializációs függvény köré, az update_pwm_outputs függvény pedig a betanított hangparancs paraméterként kapott azonosítója alapján frissíti az általunk használt 2 kimenetet.

# Forrásfájl:

#include "esp_log.h"

#include "freertos/FreeRTOS.h"

#include "freertos/semphr.h"

#include "driver/ledc.h"

#include "pwm_output.h"

#define DUTY_CYCLE_100 (uint32_t) 256U

#define DUTY_CYCLE_75 (uint32_t) 192U

#define DUTY_CYCLE_50 (uint32_t) 128U

#define DUTY_CYCLE_25 (uint32_t) 64U

#define DUTY_CYCLE_MOOD (uint32_t) 25U

#define DUTY_CYCLE_0 (uint32_t) 0U

#define DUTY_CYCLE_NUM 6U

#define OUTPUT_CHANNEL_1 (int) 4

#define OUTPUT_CHANNEL_2 (int) 5

static SemaphoreHandle_t pwm_output_mutex = NULL;

typedef enum {

DUTYC_100_IDX = 0,

DUTYC_0_IDX,

DUTYC_25_IDX,

DUTYC_50_IDX,

DUTYC_75_IDX,

DUTYC_MOOD_IDX,

} duty_cycle_idx_t;

static const uint32_t duty_cycle_values[DUTY_CYCLE_NUM] =

{

DUTY_CYCLE_100,

DUTY_CYCLE_0,

DUTY_CYCLE_25,

DUTY_CYCLE_50,

DUTY_CYCLE_75,

DUTY_CYCLE_MOOD

};

static esp_err_t init_pwm_output_mutex(void) {

pwm_output_mutex = xSemaphoreCreateMutex();

return (pwm_output_mutex != NULL) ? ESP_OK : ESP_FAIL;

}

static uint32_t select_duty_cycle_value(duty_cycle_idx_t dutyc_idx) {

return duty_cycle_values[dutyc_idx % DUTY_CYCLE_NUM];

}

static esp_err_t update_outputs(int command_id)

{

esp_err_t ret = ESP_OK;

uint32_t duty_cycle_value = select_duty_cycle_value((duty_cycle_idx_t)command_id);

if(command_id >= 0 && command_id <= 5) {

ret|= update_duty_cycle(LEDC_CHANNEL_0, &duty_cycle_value);

}

else if(command_id >= 6 && command_id <= 11) {

ret |= update_duty_cycle(LEDC_CHANNEL_1, &duty_cycle_value);

}

else{

ret |= update_duty_cycle(LEDC_CHANNEL_0, &duty_cycle_value);

ret |= update_duty_cycle(LEDC_CHANNEL_1, &duty_cycle_value);

}

return ret;

}

esp_err_t update_pwm_outputs(int command_id) {

return update_outputs(command_id);

}

A DUTY_CYCLE_* előtagú konstansok reprezetálják a kitöltési tényezőkhöz rendelt számértéket. Mivel a komponens összesen 6 különböző kitöltési tényezőt tud előállítani, ezért 8-bites rezolúció bőven elegendő. A 0 érték tartozik a 0 %-os, míg a 255 érték a 100 %-os kitöltési tényezőhöz. A duty_cycle_idx_t egy enumeráció, amely a duty_cycle_values konstans tömb elemeinek (az előbb említett konstansok) elérésére szolgál. A select_duty_cycle függvény a hangparancs azonosítója alapján választja ki maradékos osztással a fenti tömb elemeit – valójában egy „map” függvényként működik, ami mindig nullától hatig terjedő skálán választ egy indexet.

static esp_err_t update_duty_cycle(ledc_channel_t led_channel, uint32_t *new_duty_cycle_value)

{

esp_err_t ret = ESP_OK;

ret |= ledc_set_duty(LEDC_LOW_SPEED_MODE, led_channel, *new_duty_cycle_value);

ret |= ledc_update_duty(LEDC_LOW_SPEED_MODE, led_channel);

return ret;

}

# Az update_duty_cycle függvény 2 paramétert vár: az egyik az a kimeneti csatorna, a második pedig az 8-biten kódolt kitöltési tényezőt tároló érték, amely a csatornára kell, hogy kerüljön.

# Az inicializálást végző eljárás az alábbi kódrészletben található:

static esp_err_t pwm_output_init(void)

{

esp_err_t ret = ESP_OK;

ESP_ERROR_CHECK(init_pwm_output_init_mutex());

xSemaphoreTake(pwm_output_mutex, pdMS_TO_TICKS(1));

ledc_timer_config_t ledc_timer_0 = {

.speed_mode = LEDC_LOW_SPEED_MODE,

.duty_resolution = LEDC_TIMER_8_BIT,

.timer_num = LEDC_TIMER_0,

.freq_hz = 5000,

.clk_cfg = LEDC_AUTO_CLK

};

ret |= ledc_timer_config(&ledc_timer_0);

if(ret != ESP_OK) {

ESP_LOGE(TAG, "unable to configure ledc timer 0");

goto end;

}

ledc_channel_config_t ledc_channel_0 = {

.speed_mode = LEDC_LOW_SPEED_MODE,

.channel = LEDC_CHANNEL_0,

.timer_sel = LEDC_TIMER_0,

.intr_type = LEDC_INTR_DISABLE,

.gpio_num = OUTPUT_CHANNEL_1,

.duty = 0,

.hpoint = 0

};

ret |= ledc_channel_config(&ledc_channel_0);

if (ret != ESP_OK) {

ESP_LOGE(TAG, "unable to configure ledc channel 0");

goto end;

}

ledc_timer_config_t ledc_timer_1 = {

.speed_mode = LEDC_LOW_SPEED_MODE,

.duty_resolution = LEDC_TIMER_8_BIT,

.timer_num = LEDC_TIMER_1,

.freq_hz = 5000,

.clk_cfg = LEDC_AUTO_CLK};

ret |= ledc_timer_config(&ledc_timer_1);

if (ret != ESP_OK) {

ESP_LOGE(TAG, "unable to configure ledc timer 1");

goto end;

}

ledc_channel_config_t ledc_channel_1 = {

.speed_mode = LEDC_LOW_SPEED_MODE,

.channel = LEDC_CHANNEL_1,

.timer_sel = LEDC_TIMER_1,

.intr_type = LEDC_INTR_DISABLE,

.gpio_num = OUTPUT_CHANNEL_2,

.duty = 0,

.hpoint = 0};

ret |= ledc_channel_config(&ledc_channel_1);

if (ret != ESP_OK) {

ESP_LOGE(TAG, "unable to configure ledc channel 1");

goto end;

}

ESP_LOGI(TAG, "pwm outputs initialized successfully.");

end:

xSemaphoreGive(pwm_output_mutex);

return ret;

}

A pwm_output_init függvény 2 lépésben készíti elő a LEDC periféria kimenetei csatornáit: előszőr a jel előállításhoz szükséges időzítő áramkört konfigurálja, amely 5 kHz-es pwm-jelet fog előállítani, 8-bites felbontással. Második lépésként pedig magát a csatornát helyezi az konfigurációs struktúrában megadott gpio-pinre. Ez a műveletet kétszer ismételi meg. [22]

## 4.4. A voice_assistant komponens:

# A voice_assistant a projekt legfontosabb része, hiszen egyszerre hangolja az előző három komponens funkcionalitását, illetve futtatja a hangfelismerő algoritmusokat végző taszkokat.

### 4.4.1. ESP-Skainet és Speech Recognition Framework:

Ábra 19 – az ESP-Skainet felépítésének blokkdiagramja. Forrás: [23].

A voice_assistant működéséhez felhasznált legfontosabb komponens az ESP-SR (speech recognition framework) [23], amely az ESP-Skainet intelligens hangasszistens alkalmazásnak a magja. Az ESP-SR az első olyan keretrendszer, amely lehetővé tette az ESP32 mikrovezérlők számára IoT-alkalmazások mellett az AIoT megoldások létrehozását is, amelyek egyszerre használják a mesterséges intelligencia és a dolgok iternente által nyújtott lehetőségeket, létrehozva ezek stratégiai integrációját.
A fenti ábrán szereplő részegységek nem mindegyike alkotóeleme a Skainet-nek. A „Voice Input” esetünkben a kettő INMP441-es mikrofon, melynek a kimenetén megjelenő adat a Skainet első részegységébe jut, ez az Audio Front End. A digitalizált hang ezután vagy a WakeNet-, vagy közvetlenül a Multinet motorba kerül további feldolgozásra. A projekt nem használja fel TTS_* előtaggal jelölt komponenseket, az “Output” oldalon valójában a világításvezérlés valósul meg.


### 4.4.2. Audio Front End:

A hangvezérlést támogató termékek esetén alapvető követelmény, hogy azok zajos környezetben is hatékonyan, alacsony hibaránnyal működjenek. Az Audio Front End [24] (vagy röviden AFE) olyan (hang)előfeldolgozó algoritmuskészletet tartalmaz, amelyek képesek a korábban említett elvárásokat biztosítani. A szoftvercsomag lehetővé teszi, hogy a felhasználók az ESP32-S3 sorozatú csipekre egy olyan hangfelismerő „felületet” készítsenek el, amely egyszerre nagy teljesítményű és alacsony memóriaigényű. Ezen egység felelős a következő feladatok elvégzésért: accoustic echo cancellation, blind source separation, noise suppresion, voice activity detection és automatic gain control. Az első három a bemeneti oldalra kerülő hangminták zajtalanítása és „tisztítása”, míg az utolsó kettő a bemenet kifinomultabb érzékeléséért és szükséges erősítéséért felelős.

# Az AFE dokumentáció egyik, ha nem a legfontosabb eleme az AFE-ba kerülő hangminták formátuma. Két mikrofonos megoldás esetén: 16 kHz-es és 16-bites adatot vár a következő sorrendben és formátumban (a Skainet kizárólag PCM formátumot támogat):

Ábra 20 – az AFE által elvárt adatformátum. Forrás: [24].

Jól látható, hogy először a baloldali mikrofonból, majd a jobb oldali mikrofonból, végül a referencia mikrofonból érkező adatra várakozik. A projekt megvalósítása során én csak kettőt használtam, viszont egyiket sem referenciaként, hiszen egy beltéri környezetre készítettem a projektet, ahol nincs annyi háttérzaj, mint egy kültéri helyiségben. Az Audio Front End a következő mikrofonkiosztásokat támogatja:

Ábra 21 – az AFE által támogatott mikrofonkonfigurációk. Forrás: [24].

# Számunkra a harmadik konfiguráció kiválasztása szükséges, illetve az AEC funkció kikapcsolása, hiszen nincs referenciamikrofonunk, amely viszonyítási hangszintet biztosítani a visszhang szűréséhez.

### 4.4.3. WakeNet:

Ez egy mesterséges neuronhálót használó szoftveregység, amely az ébresztő hangparancsok felismerését végzi. Nagy teljesítménye , memóriatakarékossága és az általa támogatott ébresztőparancsok (“Hi, ESP!”, “Alexa”, “Jarvis”, “Hi, Lexin!”, stb.) hosszú sora teszi igazán vonzóvá. A projektben az „Alexa” wakeword-t használtam fel. A WakeNet [25] az ébresztőparancsok detektálásához az MFCC (Mel-Frekvencia Cepstrum Koeficiens) módszert használja, melynek lényege, hogy a beszédhangot alkotó jelet komponensekre bontja aszerint, hogy a hangzása milyen formában hat az emberi fülre. Az alábbi ábrán jól látható, hogy „ablakozással” az beszédből kiragadnak egy adott hosszúságú keretet, amelyet később a spektrális komponensek alapján az eljárás által használt koefficiensekre bontanak. Az MFCC módszere természetesen több lépést is magába foglal, de ezekkel a jelenlegi dokumentumban nem foglalkozom részletesen. A WakeNet-ben használt neurális modellek száma mára már eléri a kilencet, legfőképpen a támogatott ESP32 csipek típusában és a betanítható ébresztőparancsok számában különböznek. A jelenlegi projekt a WakeNet 9. kiadását használja.


Ábra 23 – MFCC eljárás. Forrás: [25].

Ábra 24 – A Multinet működésének folyamatábrája. Forrás: [26].

### 4.4.4. MultiNet:

A MultiNet [26] egy könnyed hangfelismerő mesterséges intelligencia modell, amely az offline hangfelismerő algoritmusokat futtatja az ESP32 mikrovezérlőkön. Jelenleg akár 200 parancsot is képes megtanulni, angol és kínai nyelven egyaránt (a modell egyszerre csak egy nyelv használatát támogatja). A MultiNet (és a WakeNet) mesterséges intelligencia modellek használatához, először a a fejlesztőkit flash memóriájából el kell különítenünk egy partíciót, amely a modellek tárolására szolgál. Az idf egy .csv kiterjesztésű fájl segítségével lehetővé teszi a flash memória egyéni partícionálását: A fájl létrehozása után, a menuconfig segítségével a fájl elérési útvonalát kell megadni. Az általam kialakított partíciókat a következő fájl szemléleti:

# partitions.csv fájl:

# ESP-IDF Partition Table

# Using the default Single factory app, no OTA partition, extending with a spiffs partition, used by the wakenet models

# Name, Type, SubType, Offset, Size, Flags

nvs, data, nvs, , 0x6000,

phy_init, data, phy, , 0x1000,

factory, app, factory, , 3000K,


model, data, spiffs, , 3800K,

Ábra 25 – a menuconfig „Speech Recognition” almenüje

A MultiNet-nek összesen három kiadása ismert: különböznek, mind a felhasznált erőforrások mennyiségében, illetve a betanított hangparancsok formátumában: a MultiNet 5 és 7 a parancsokat fonémaként, míg MultiNet 6 esetén tároljuk a konfigurációs fájlban. A kettő tárolási formátum közötti különbséget az következő ábrák szemléltetik:
A projekt megvalósításához a Multinet 5-ös verzióját használtam. Ahhoz, hogy a szövegesen beírt hangparacsokat fonémákká alakítsam, a g2p.py Python-nyelven megírt szkriptet használtam.

Ábra 26 – Multinet 5 és 7 tárolási formátuma fent, Multinet 6 tárolási formátuma lent. Forrás: [26].

# sdkconfig fájl

# ESP Speech Recognition

CONFIG_USE_AFE=y

CONFIG_USE_WAKENET=y

CONFIG_SR_WN_WN9_ALEXA=y

CONFIG_USE_MULTINET=y

CONFIG_SR_MN_EN_MULTINET5_SINGLE_RECOGNITION_QUANT8=y

# Add English speech commands

CONFIG_EN_SPEECH_COMMAND_ID0="TkN nN ZbN WcN"

CONFIG_EN_SPEECH_COMMAND_ID1="TkN eF ZbN WcN"

CONFIG_EN_SPEECH_COMMAND_ID2="ZbN WcN BRiTNcS TWfNTgViF PkSfNT"

CONFIG_EN_SPEECH_COMMAND_ID3="ZbN WcN BRiTNcS FgFTm PkSfNT"

CONFIG_EN_SPEECH_COMMAND_ID4="ZbN WcN BRiTNcS ScVfNTcFiT PkSfNT"

CONFIG_EN_SPEECH_COMMAND_ID5="ZbN WcN MoD LiT"

CONFIG_EN_SPEECH_COMMAND_ID6="TkN nN ZbN To"

CONFIG_EN_SPEECH_COMMAND_ID7="TkN eF ZbN To"

CONFIG_EN_SPEECH_COMMAND_ID8="ZbN To BRiTNcS TWfNTgViF PkSfNT"

CONFIG_EN_SPEECH_COMMAND_ID9="ZbN To BRiTNcS FgFTm PkSfNT"

CONFIG_EN_SPEECH_COMMAND_ID10="ZbN To BRiTNcS ScVfNTcFiT PkSfNT"

CONFIG_EN_SPEECH_COMMAND_ID11="ZbN To MoD LiT"

CONFIG_EN_SPEECH_COMMAND_ID12="TkN nN jc LiTS"

CONFIG_EN_SPEECH_COMMAND_ID13="TkN eF jc LiTS"

CONFIG_EN_SPEECH_COMMAND_ID14="BRiTNcS TWfNTgViF PkSfNT"

CONFIG_EN_SPEECH_COMMAND_ID15="BRiTNcS FgFTm PkSfNT"

CONFIG_EN_SPEECH_COMMAND_ID16="BRiTNcS ScVfNTcFiT PkSfNT"

CONFIG_EN_SPEECH_COMMAND_ID17="MoD LiT"

Az alábbi konfigurációs fájlbeli részlet a Skainet konfigurációs beállításait és a projektben betanított hangparancsokat mutatja be fonémás alakban. Például a CONFIG_EN_SPEECH_COMMAND_ID0-ban található fonéma a “Turn on the lights” parancsot kódolja. Az hozzájuk rendelt ID segítségével azonosítjuk be a parancsot, majd hajtjuk végre a megfelelő szalag ki-, be- vagy dimmelt kapcsolását.

# voice_assistant.h fájl

#pragma once

#include "freertos/FreeRTOS.h"

#include "freertos/task.h"

#include "esp_log.h"

void start_voice_assistant(void);

#define AFE_CUSTOM_CONFIG()

{

.aec_init = false,

.se_init = true,

.vad_init = true,

.wakenet_init = true,

.vad_mode = VAD_MODE_4,

.wakenet_model_name = "wn9_alexa",

.wakenet_mode = DET_MODE_2CH_95,

.afe_mode = SR_MODE_HIGH_PERF,

.afe_perferred_core = 0,

.afe_perferred_priority = 5,

.afe_linear_gain = 1.0,

.memory_alloc_mode = AFE_MEMORY_ALLOC_MORE_PSRAM,

.agc_mode = AFE_MN_PEAK_AGC_MODE_2,

.pcm_config.total_ch_num = 2,

.pcm_config.mic_num = 2,

.pcm_config.ref_num = 0,

.pcm_config.sample_rate = 16000,

.debug_init = false,

.debug_hook = {{AFE_DEBUG_HOOK_MASE_TASK_IN, NULL},

}

A hangfelismerő komponens header-jében egyetlen függvény és egy makró található. A makró az Audio Front End-et reprezentáló struktúra mezőit inicializálja a következő értékkel. A visszhang csillapítása (aec_init) nincs engedélyezve tekintettel a pcm_config* előtagú beállítások értékeire: összesen 2 hangforrásunk (mikrofonok) van, amelyek 16 kHz-en mintavételeznek és egyik sem szolgál referenciaként. A WakeNet modell neve és az általa támogatott ébresztőparancs az “Alexa!”, amely a szükséges memóriát a PSRAM-ból igyekszik allokálni.

# voice_assisstant.c fájl

#include <stdbool.h>

#include "esp_wn_iface.h"

#include "esp_wn_models.h"

#include "esp_afe_sr_models.h"

#include "esp_afe_config.h"

#include "model_path.h"

#include "esp_mn_iface.h"

#include "esp_mn_models.h"

#include "model_path.h"

#include "esp_process_sdkconfig.h"

#include "esp_log.h"

#include "voice_assistant.h"

#include "bsp.h"

#include "led_indicator.h"

#include "pwm_output.h"

/* Private mutex used for initialization */

static SemaphoreHandle_t sr_init_mutex = NULL;

static esp_afe_sr_iface_t *_afe_handle = NULL;

/* Private AFE data container */

static esp_afe_sr_data_t *_afe_data = NULL;

/* Private wakenet interface */

const esp_wn_iface_t *wakenet = NULL;

/* Private multinet interface */

const esp_mn_iface_t *multinet = NULL;

model_iface_data_t *mn_model_data = NULL;

# Az alábbi NULL értékre inicializált mutatók olyan entitásokat jelölnek, melyek kötelezően jelen kell lenniük a hangfelismerést végző komponens inicializáló- és feldolgozó eljárásaiban. Az inicializációs folyamat szintén védett az sr_init_mutex által.

static esp_err_t sr_flash_models(void)

{

ESP_ERROR_CHECK(init_sr_mutex());

xSemaphoreTake(sr_init_mutex, pdMS_TO_TICKS(0));

srmodel_list_t *models = esp_srmodel_init("model");

if (models == NULL) {

ESP_LOGE(TAG, "Unable to load model(s)");

return ESP_FAIL;

}

char *wn_name = esp_srmodel_filter(models, ESP_WN_PREFIX, "wn9_alexa");

wakenet = esp_wn_handle_from_name(wn_name);

model_iface_data_t *wn_model_data = wakenet->create("wn9_alexa", DET_MODE_2CH_95);

char *mn_name = esp_srmodel_filter(models, ESP_MN_PREFIX, ESP_MN_ENGLISH);

multinet = esp_mn_handle_from_name(mn_name);

mn_model_data = multinet->create(mn_name, 5000);

esp_mn_commands_update_from_sdkconfig(multinet, mn_model_data);

/* Initialize the afe_handle */

_afe_handle = (esp_afe_sr_iface_t *)&ESP_AFE_SR_HANDLE;

afe_config_t afe_cfg = AFE_CUSTOM_CONFIG();

_afe_data = _afe_handle->create_from_config(&afe_cfg);

xSemaphoreGive(sr_init_mutex);

return ESP_OK;

}

# Az sr_flash_models függvény kiolvassa és előkészíti a program feltöltésekor a flash memóriába kerülő mesterséges intelligencia modelleket és a betanított parancsokat. Miután végzett, az Audio Front End-t kezelő entitást inicializálja a header-ben található makró segítségével.


Ábra 27 – Az Audio Front End működési vázlata hangfelismerő üzemmódban. Forrás: [24].

static void feed_task(void *arg)

{

esp_afe_sr_data_t *afe_data = arg;

int audio_chunksize = _afe_handle->get_feed_chunksize(afe_data);

int nch = _afe_handle->get_channel_num(afe_data);

int feed_channel = bsp_board_channel_fmt();

int16_t *i2s_buff = (int16_t *)calloc(audio_chunksize * feed_channel,

sizeof(int16_t));

ESP_LOGI(TAG, "feed_task started");

while (1) {

ESP_ERROR_CHECK(bsp_read_i2s_data( i2s_buff,

audio_chunksize*feed_channel, sizeof(int16_t)));

_afe_handle->feed(afe_data, i2s_buff);

}

}

static void fetch_task(void *arg)

{

esp_afe_sr_data_t *afe_data = arg;

int afe_chunksize = _afe_handle->get_fetch_chunksize(afe_data);

int mu_chunksize = multinet->get_samp_chunksize(mn_model_data);

assert(mu_chunksize == afe_chunksize);

bool detect_flag = false;

led_indicator_t led_indicator = led_indicator_init();

ESP_ERROR_CHECK(led_indicator_start(led_indicator));

ESP_LOGI(TAG, "fetch_task started");

while (1) {

afe_fetch_result_t *res = _afe_handle->fetch(afe_data);

if (res->wakeup_state == WAKENET_DETECTED) {

printf("wakeword detected\n");

multinet->clean(mn_model_data);

_afe_handle->disable_wakenet(afe_data);

led_indicator_turn_on(led_indicator);

detect_flag = true;

}

if(detect_flag == true)

{

esp_mn_state_t mn_state = multinet->detect(mn_model_data, res->data);

if (mn_state == ESP_MN_STATE_DETECTING) {

continue;

}

if (mn_state == ESP_MN_STATE_DETECTED) {

/* Check the results calculated by Multinet */

esp_mn_results_t *mn_result = multinet->get_results(mn_model_data);

int command_id = (mn_result->command_id[0]);

(void) update_pwm_outputs(command_id);

ESP_LOGI(TAG, "-----------listening-----------\n");

}

if (mn_state == ESP_MN_STATE_TIMEOUT) {

esp_mn_results_t *mn_result = multinet->get_results(mn_model_data);

_afe_handle->enable_wakenet(afe_data);

detect_flag = false;

led_indicator_turn_off(led_indicator);

ESP_LOGI(TAG, "-----------awaits to be waken up-----------\n");

}

}

}

}

Ahogy a fenti ábrán látható, a Skainet működéséhez 2 feladatot kell definiálnunk, amelyek a feed és a fetch. A feed_task először egy adott mennyiségű hangmintát előfeldolgoz, majd megtisztítja a felesleges zajoktól – ebben a programegységben sem a WakeNet, sem a MultiNet nem akív. A fetch_task ezután kiolvassa egy belső pufferből az előkészített hangmintákat és a mesterséges intelligencia modelleknek továbbítja. A két taszk részletes működéséről a következő fejezetben teszek említést.

### 4.4.5. A feed taszk működése:

A feed_task első lépésként a paraméterben kapott mutatót konvertálja afe_data típusúra, ezáltal elérthetővé válik az Audio Front End által támogatott adatformátum. Az i2s_buff az a 16-bites egészeket tartalmazó tömb lesz, amelybe a feldolgozandó hang digitalizált értékei kerülnek – ennek mérete az AFE által lekért darabszám szorozva kettővel (feed_channel), hiszen sztereó módban olvassuk a pcm formátumú adatokat. Ezután a végtelen while-ciklusban a hardware_driver komponens bsp_read_i2s_data függvényét használjuk, amivel az I2S-csatornákon érkező adatokat olvassuk be pufferbe, amelyet ezután feldolgoz az _afe_handle objektum feed függvénye.

### 4.4.6. A fetch taszk működése:

A fetch_task kezdő lépései szinte ugyanazok, mint a feed taszk esetén, annyi különbséggel, hogy itt hozom létre a led_indicator objektumot, majd indítom el – alap állapotban a fehér jelző LED dióda nem világít. A detect_flag változót arra használom, hogy jelezni tudjam az algoritmus számára, hogy jelenleg milyen állapotban van a program. Az afe_fetch_result_t típusú res változó a feed taszkban feldolgozott hangmintát és a hozzá tartozó egyéb információkat tartalmazza (fontos megemlíteni, hogy a feed és fetch taszkok az idf-keretrendszer szinjtén egymás között szinkronizálva vannak). A végtelen while-ciklusban a következő folyamat zajlik: folyamatosan olvassuk és feed taszk által feldolgozott hangmintákat és a hozzájuk tartozó metainformációkat alapján lépünk be az algoritmus különböző ágaiba. Amennyibe egy ébresztő parancsot észlelünk (teljesül res->wakeup_state == WAKENET_DETECTED feltétel), kikapcsoljuk a WakeNetet, felkapcsoljuk a fehéren világító LED diódát, majd billentjük a detect_flag változót. Miután a detektálást jelző flag aktív, tovább olvassuk a feldolgozott hangot és amennyiben egy előre betanított hangparacsont észlel a Multinet (teljesül az mn_state == ESP_MN_STATE_DETECTED feltétel), az mn_result változóban a Multinet által felismert parancsok találhatóak meg valószínűség alapján, csökkennő sorrendben (ezért mentjük el a tömb első elemét a command_id nevű változóba). A command_id alapján ezután frissítjük a 2 pwm-kimenetet, így a LED-szalagok az adott erősségű fénnyel fognak világítani. A MultiNet ezután még 5 másodpercig aktív állapotban marad, miután ez az időtartam lejárt(az mn_state == ESP_MN_STATE_TIMEOUT feltétel teljesül), engedélyezzük a WakeNetet, negáljuk a detect_flag változót és kikapcsoljuk a LED diódát. Az update_pwm_outputs függvény lehetővé teszi a két zóna egymástól független kapcsolását.


Ábra 28 – az 1-es zóna 75%-os, míg a 2-es 25%-os kitöltési tényezővel világít

static esp_err_t init_sr_tasks(void)

{

ESP_ERROR_CHECK(sr_flash_models());

esp_err_t ret = ESP_OK;

xSemaphoreTake(sr_init_mutex, pdMS_TO_TICKS(10));

ret = (xTaskCreatePinnedToCore(&feed_task, "feed", 8 * 1024, (void *)_afe_data, 10, NULL, 0) == pdTRUE) ? ESP_OK : ESP_FAIL;

ret = (xTaskCreatePinnedToCore(&detect_task, "detect", 4 * 1024, (void *)_afe_data, 10, NULL, 1) == pdTRUE) ? ESP_OK : ESP_FAIL;

xSemaphoreGive(sr_init_mutex);

return ret;

}

Az init_sr_tasks függvény első lépésként elvégzi a Skainet 3 komponensének konfigurálását, majd definiál kettő FreeRTOS taszkot, a megfelelő paraméterrel, veremmérettel és prioritással – fontos, hogy a két taszk fizikailag és a mikrovezérlő két különálló processzormagján fusson a számítási teljesítmény maximalizálásának érdekében (xTaskCreatePinnedToCore).

void start_voice_assistant(void)

{

ESP_ERROR_CHECK(init_pwm_outputs());

ESP_ERROR_CHECK(bsp_board_init(16000, 2, 32));

ESP_ERROR_CHECK(init_sr_tasks());

}

# A voice_assistant utolsó függvénye az előző eljárásokat hívja meg egymás után, az ESP_ERROR_CHECK makró pedig megállítja a program futását és jelzi, ha bármelyik függvény hibával tér vissza.

## 4.5. A program belépési pontja:

# main.c fájl:

#include <stdio.h>

#include <stdlib.h>

#include "esp_log.h"

#include "voice_assistant.h"

#define TAG "main"

void app_main(void)

{

start_voice_assistant();

}

# A program indítása egyszerű: az app_main függvényben meghívjuk a voice_assisstant-beli start_voice_assistant függvényt.

# 5. A diplomamunka eredménye:

Az alábbi képeken megtekinthető az elkészült prototípus. elkészítésénél törekedtem a tömör kialakításra és a könnyen szerelhetőségre. Maga az áramkör egy átlátszó műanyag dobozba került, amelyen a szükséges furatok is megtalálhatóak. A doboz bárhova elhelyezhető, ahol könnyen éri a hang (akár falra is), illetve közel vannak LED szalagok vezetékei.


Az áramkör elkészítéséhez egy eredeti Alexa-t támogató termék árának töredékét használtam fel. A projekt a jövőben megalapozhatja egy komolyabb áramkör/eszköz megépítését is, amely sokkal több kimenettel és vezérlési móddal (MQTT, WIFI, Zigbee) képes működni. Nem titkolt célom az, hogy megtanuljak nyomtatott áramköri lapokat készíteni, megalkotva egy sokkal elegánsabb és szakszerűbb eszközt.

Ábra 29 – az általam elkészített áramköri lap és a tárolásához szükséges doboz.

# 6. Irodalomjegyzék:

[1]: ESP32 mikrovezérlő ismertető

Megtekintés dátuma: 2024.07.01.

https://www.espressif.com/en/products/socs/esp32

[2]: Hangfelismerés fogalma

Megtekintés dátuma: 2024.07.01.

https://hu.shaip.com/blog/voice-recognition-overview-and-applications/

[3]: ESP-IDF keretrendszer:

Megtekintés dátuma: 2024.07.01.

https://github.com/espressif/esp-idf

[4]: Espressif cég ismertető

Megtekintés dátuma: 2024.07.01.

https://www.espressif.com/

[5]: ESP32 DevkitC ismertető és lábkiosztás:

Megtekintés dátuma: 2024.07.01.

https://docs.espressif.com/projects/esp-dev-kits/en/latest/esp32/esp32-devkitc/user_guide.html

[6]: ESP32-S3 DevkitC ismertető és lábkiosztás:

Megtekintés dátuma: 2024.07.01.

https://docs.espressif.com/projects/esp-idf/en/v5.2.3/esp32s3/hw-reference/esp32s3/user-guide-devkitc-1.html

[7]: PSRAM csip ábra:
Megtekintés dátuma: 2024.07.01.

https://www.gridconnect.com/products/esp-psram-64-for-wroom-32-and-esp32

[8]: MEMS-technológia és MEMS-mikrofonok:

Megtekintés dátuma: 2024.07.04.

https://www.magyar-elektronika.hu/tartalom/mems-mikrofonok-segitik-a-hangeszlelest-es-a-kulcsszofelismerest-a-hangvezerelt-rendszerekben

[9]: MEMS-mikrofon csip ábra:

Megtekintés dátuma: 2024.07.04.

https://invensense.tdk.com/products/digital/t5818/

[10]: INMP441 adatlap és ábrák:

Megtekintés dátuma: 2024.07.04.

https://invensense.tdk.com/wp-content/uploads/2015/02/INMP441.pdf

[11]: INMP441 csippel szerelt mikrofonmodul

Megtekintés dátuma: 2024.07.04.

https://techiesms.com/product/inmp441-microphone-module-i2s/

[12]: I²S szabvány ismertető:

Megtekintés dátuma: 2024.07.06.

https://www.feasycom.com/hu/what-is-audio-i2s-interface.html

[13]: ESP-IDF I²S könyvtár:

Megtekintés dátuma: 2024.07.06.

https://docs.espressif.com/projects/esp-idf/en/stable/esp32/api-reference/peripherals/i2s.html

[14]: Felhasznált LED szalag ismertető:

Megtekintés dátuma: 2024.07.07.

https://www.elementa.rs/proizvod/61062/led-traka-toplo-bela-120-led-1m

[15]: AC-DC átalakító:

Megtekintés dátuma: 2024.07.08.

https://www.elementa.rs/proizvod/65129/ispravljac-12v-3a

[16]: LM2595 tápegység:

Megtekintés dátuma: 2024.07.08.

https://www.addicore.com/products/lm2596-step-down-adjustable-dc-dc-switching-buck-converter

[17]: IRL-540N tranzisztor:

Megtekintés dátuma: 2024.07.11.

https://www.elementa.rs/proizvod/15979/fet-tranzistor-n-logl-to220

[18]: Laboratory practical with the C8051Fxxx microcontroller family

Megtekintés dátuma: 2024.07.12.

https://eta.bibl.u-szeged.hu/901/

[19]: FreeRTOS ismertető és ábra

Megtekintés dátuma: 2024.07.18.

https://www.freertos.org/

[20]: WS2812 címezhető RGB-LED IC

Megtekintés dátuma: 2024.07.21.

https://cdn-shop.adafruit.com/datasheets/WS2812.pdf

[21]: IDF Component Manager:

Megtekintés dátuma: 2024.07.21.

https://docs.espressif.com/projects/idf-component-manager/en/latest/

[22]: ESP-IDF LEDC könyvtár:

Megtekintés dátuma: 2024.07.22.

https://docs.espressif.com/projects/esp-idf/en/stable/esp32/api-reference/peripherals/ledc.html

[23]: ESP-IDF Skainet könyvtár

Megtekintés dátuma: 2024.07.23.

https://github.com/espressif/esp-skainet

[24]: ESP-IDF Audio Front-end keretrendszer:

Megtekintés dátuma: 2024.07.24.

https://docs.espressif.com/projects/esp-sr/en/latest/esp32s3/audio_front_end/README.html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

[25]: ESP-IDF WakeNet keretrendszer:

Megtekintés dátuma: 2024.07.25.

https://docs.espressif.com/projects/esp-sr/en/latest/esp32s3/wake_word_engine/README.html

[26]: ESP-IDF MultiNet keretrendszer:

Megtekintés dátuma: 2024.07.25.

https://docs.espressif.com/projects/esp-sr/en/latest/esp32s3/speech_command_recognition/README.html

# 7. Nyilatkozat:

Alulírott Fodor Teodor mérnökinformatikus BSc szakos hallgató, kijelentem, hogy a dolgozatomat a Szegedi Tudományegyetem, Informatikai Intézet Műszaki Informatika Tanszékén készítettem, mérnökinformatikus BSc diploma megszerzése érdekében.

Kijelentem, hogy a dolgozatot más szakon korábban nem védtem meg, saját munkám eredménye, és csak a hivatkozott forrásokat (szakirodalom, eszközök stb.) használtam fel.

Tudomásul veszem, hogy szakdolgozatomat / diplomamunkámat a Szegedi Tudományegyetem Informatikai Intézet könyvtárában, a helyben olvasható könyvek között helyezik el.

2024. július 28.

# Mellékletek:

Az alábbi GitHub repository-ban tekinthető meg a forráskód:

https://github.com/Teodor12/ESP-32-SMART-LIGHTING/tree/development
