Teodor12/ESP-32-SMART-LIGHTING/sr_circuit/circuit_1.png

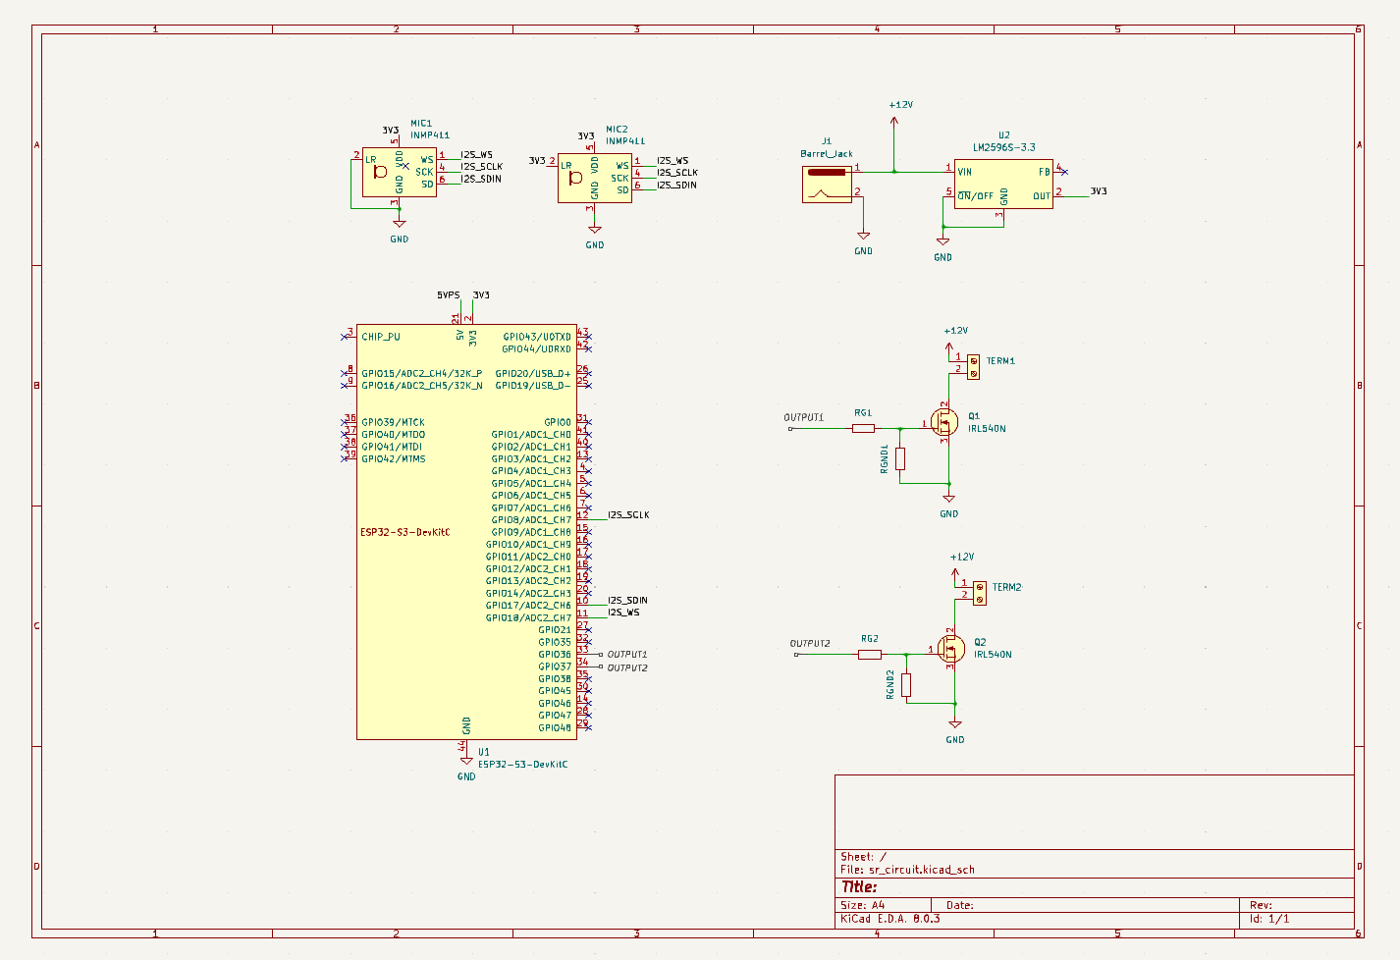
sr_circuit/circuit_1.png
