Teodor12/ESP-32-SMART-LIGHTING/ESP-32-SMART-LIGHTING_HARDWARE/ESP-32-SMART-LIGHTING.kicad_pcb

## KiCad design ESP-32-SMART-LIGHTING_HARDWARE/ESP-32-SMART-LIGHTING.kicad_pcb (2024-11-17)

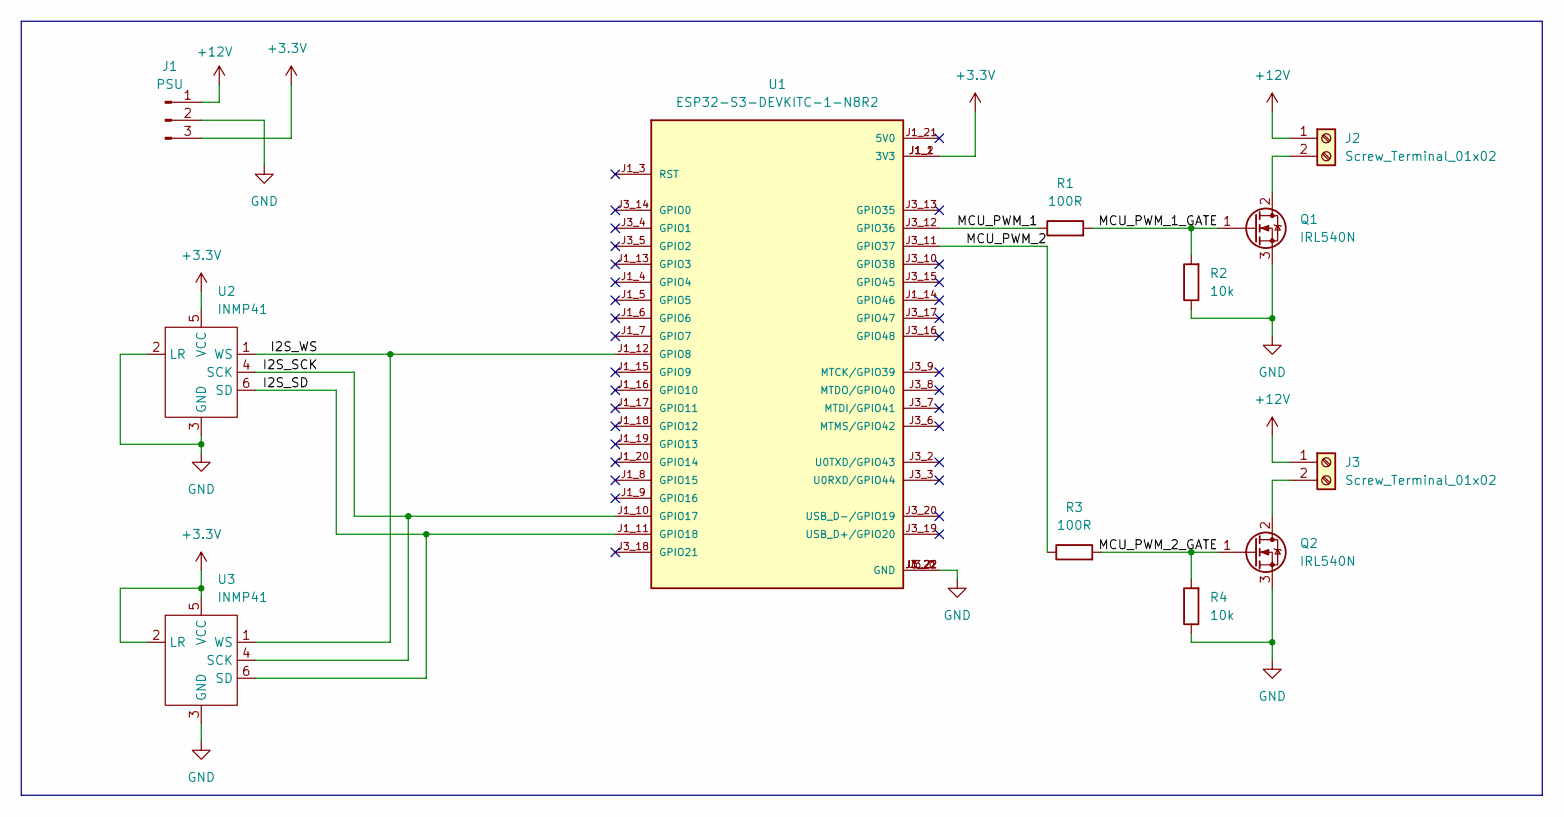
[picture p34: schematic ESP-32-SMART-LIGHTING.kicad_sch]

Parts:
J1: PSU; TerminalBlock_Xinya_XY308-2.54-3P_1x03_P2.54mm_Horizontal
J2, J3: Screw_Terminal_01x02; TerminalBlock_Xinya_XY308-2.54-2P_1x02_P2.54mm_Horizontal
Q1, Q2: IRL540N; TO-220-3_Vertical
R1, R3: 100R; R_Axial_DIN0204_L3.6mm_D1.6mm_P7.62mm_Horizontal
R2, R4: 10k; R_Axial_DIN0204_L3.6mm_D1.6mm_P7.62mm_Horizontal
U1: ESP32-S3-DEVKITC-1-N8R2; XCVR_ESP32-S3-DEVKITC-1-N8R2; PARTREV V1
U2, U3: INMP41

Connections:
+3.3V: J1.3, U1.J1_1 (3V3), U1.J1_2 (3V3), U2.5 (VCC), U3.2 (LR), U3.5 (VCC)
+12V: J1.1, J2.1, J3.1
/I2S_SCK: U1.J1_10 (GPIO17), U2.4 (SCK), U3.4 (SCK)
/I2S_SD: U1.J1_11 (GPIO18), U2.6 (SD), U3.6 (SD)
/I2S_WS: U1.J1_12 (GPIO8), U2.1 (WS), U3.1 (WS)
/MCU_PWM_1: R1.1, U1.J3_12 (GPIO36)
/MCU_PWM_1_GATE: Q1.1 (G), R1.2, R2.2
/MCU_PWM_2: R3.1, U1.J3_11 (GPIO37)
/MCU_PWM_2_GATE: Q2.1 (G), R3.2, R4.2
GND: J1.2, Q1.3 (S), Q2.3 (S), R2.1, R4.1, U1.J1_22 (GND), U1.J3_1 (GND), U1.J3_21 (GND), U1.J3_22 (GND), U2.2 (LR), U2.3 (GND), U3.3 (GND)
unnamed: J2.2, Q1.2 (D)
unnamed: J3.2, Q2.2 (D)

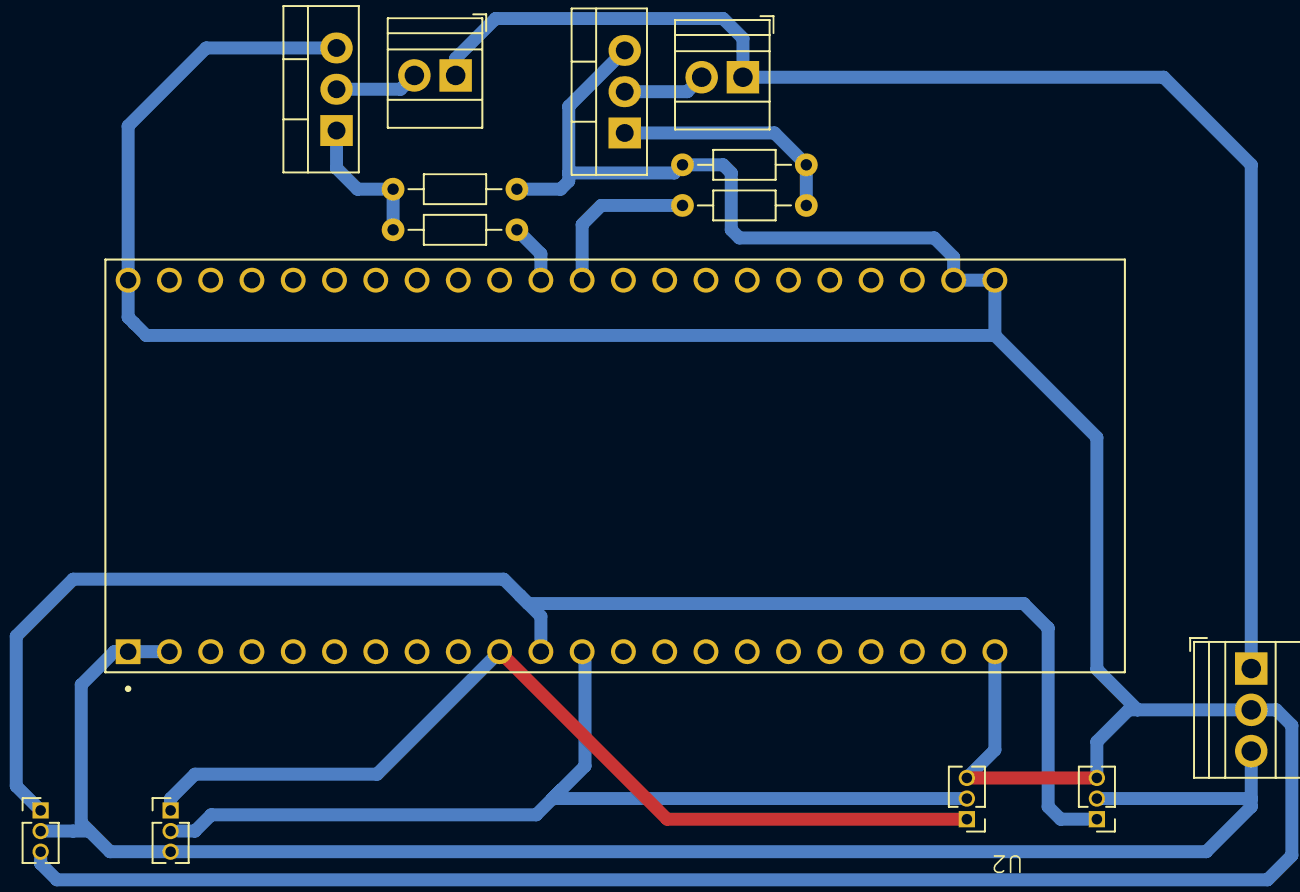
[picture p35: board ESP-32-SMART-LIGHTING.kicad_pcb from above]

Board: 2 copper layers, 12 parts (0 on the bottom side), 12 nets.
