Teodor12/ESP-32-SMART-LIGHTING/(commit log)

2024-03-29 test i2s driver
2024-04-06 add partition table and configure PSRAM
    [partition_table_for_model.csv]
2024-04-10 update i2s reading, fix sample numbers
    [voice_assistant.c]
2024-04-13 add thread-safe task initialization
2024-04-14 replace the bit shifting in hardware driver
    The hardware driver (in the example project used for board ESP32-S3 EYE) shifts the microphone data right by 14
    places(the boards has a built-in INMP441 MEMS microphone chip). For further details check the comments in the
    example project.
2024-05-01 add led_strip idf-component
2024-05-01 add led_indicator component
2024-05-01 integrate led_indicator into wakeword detection
2024-06-06 add schematics for project
    [sr_circuit.kicad_pcb, sr_circuit.kicad_sch]
2024-06-06 change names and resistor values
    [sr_circuit.kicad_sch]
2024-06-10 add 'pwm_output' component
2024-06-10 change partition sizes
    [partition_table_for_model.csv]
2024-06-10 integrate pwm_output component
2024-06-13 add external power supply
    [sr_circuit.kicad_sch]
2024-07-04 add buckboost IC
    [sr_circuit.kicad_sch]
2024-07-08 update hash of led_strip component
2024-07-10 add LED, PWM, other items
2024-07-11 Add images of the circuit
2024-07-11 add first part of the circuit details
2024-07-20 add led_indicator and pwm_output to docs
2024-09-26 PCB desing
    [ESP-32-SMART-LIGHTING.kicad_pcb, ESP-32-SMART-LIGHTING.kicad_sch]
2024-09-29 Fixed PCB size, fixed module size
    [ESP-32-SMART-LIGHTING.kicad_pcb, ESP-32-SMART-LIGHTING.kicad_sch]
